danieledel288-code/RC-Ball-Launching-Buggy/media/Bottom Up View.jpeg

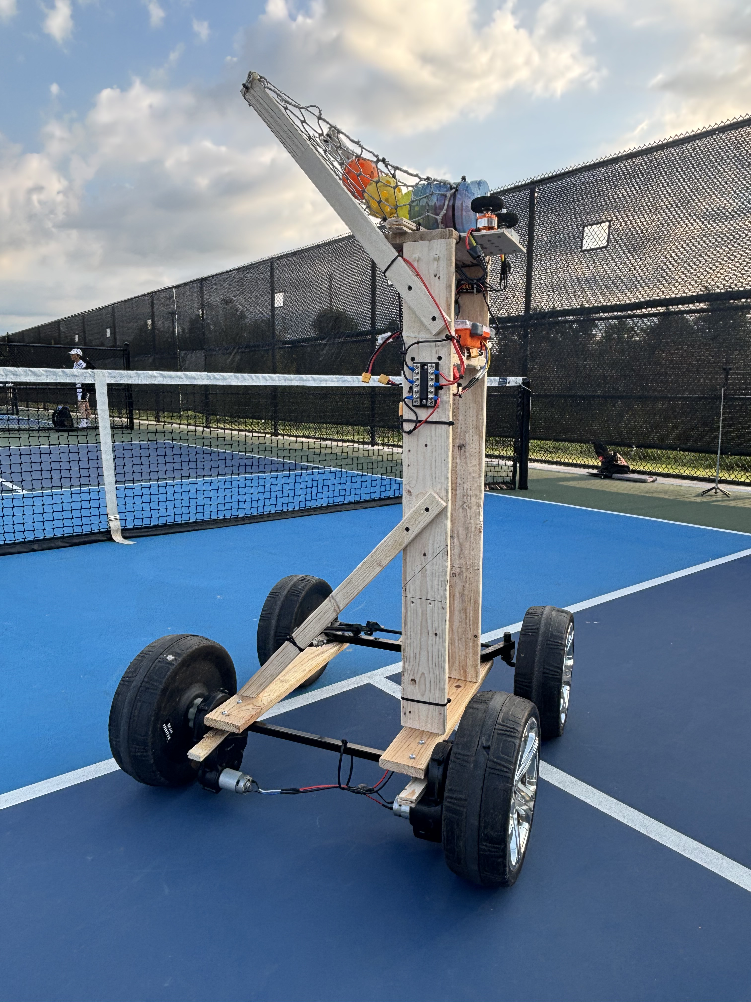
media/Bottom Up View.jpeg
