danieledel288-code/RC-Ball-Launching-Buggy/media/Fly Wheel Veiw.jpeg

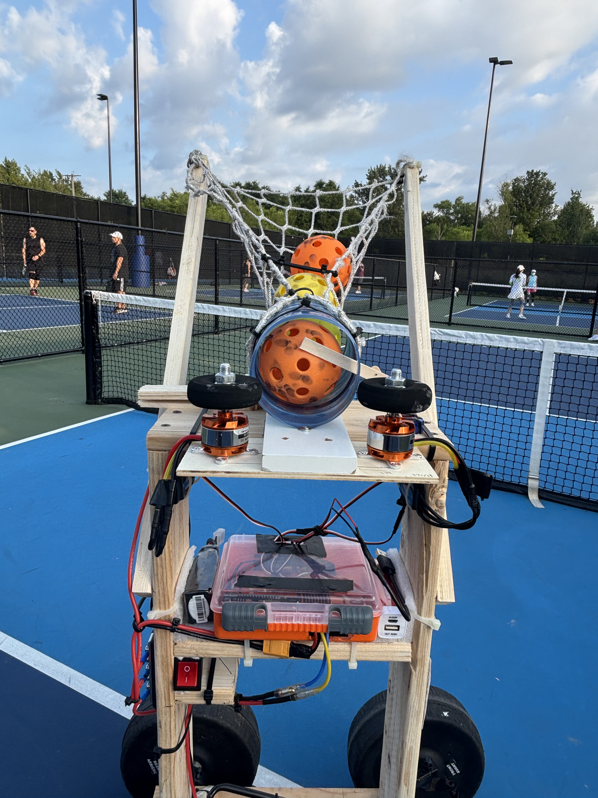
media/Fly Wheel Veiw.jpeg
