danieledel288-code/RC-Ball-Launching-Buggy/README.md

# RC Ball-Launching Buggy

Control code for an autonomous pickleball launcher built on a gutted toy car chassis, entered in the Blueprint.io Summer Build Contest.

An ESP32 hosts its own WiFi access point, so a phone can connect and control the launcher directly with no home router or internet connection needed. Two flywheel ESCs, a drive ESC, and a gate servo are all driven through a PCA9685 PWM board over I2C. The net stores a batch of balls and feeds them one at a time through the gate rather than catching live returns.

## Files

- **`flywheel_control/flywheel_control.ino`** - Manual control sketch. Hosts a WiFi access point and a web control page: arm/stop, independent speed sliders for each flywheel motor, gate open/close, and a confirm-gated "Drive Burst" button that runs the drive ESC forward for 2 seconds then returns to neutral. Includes a heartbeat watchdog that stops the flywheel/drive motors if the connection to the phone is lost.
- **`train/train.ino`** - Demo/training sketch. The buggy is always fully stopped when it shoots: SHOOT (gate open, drive neutral) -> cooldown -> DRIVE one segment -> cooldown -> SHOOT again. "Balls per pass" shots include both endpoints of the net length - 2 per pass fires one at the near end and one at the far end, 4 per pass fires at the near end, 1/3, 2/3, and the far end. The last shot of a pass is already at the far end, so direction flips and the next pass's first shot fires right there with no extra drive (the one exception is a 1-ball pass, which still drives the full length after its single shot since there's no second endpoint to space against). Flywheels spin up once and stay spinning through the whole run. Gate open time (500ms) and the post-shoot pause (300ms) are fixed in code, not user-adjustable - both tested fine and didn't need sliders.
  - **Spin:** a 3-way selector (Straight / Spin right / Spin left) next to Flywheel Power. Spin runs one flywheel 50 points slower than the other - e.g. at 75% power, "spin right" holds the right motor at 75% and drops the left to 25%. Which button actually curves the ball which way is unverified (`setFlywheels()` in code documents the assumed mapping); test both in practice and flip the mapping there if it's backwards.
  - **Forward speed / Reverse speed are separate sliders**, not one shared Drive Power. Field testing on 2026-08-16 confirmed reverse runs roughly twice as fast as forward at the same commanded percent on this ESC - same pulse value, clearly different real speed. Forward: min 40%, default 60%. Reverse: min 30%, default 30%. The two defaults are picked to feel roughly speed-matched in practice; tune independently from here.
  - **Direction-change double-tap** (fixed, not exposed as sliders): the first drive segment after an in-run direction flip goes neutral hold -> brief arm-tap pulse in the new direction -> neutral again -> the real pulse that actually drives. This was pulled out on 2026-08-16 once separate forward/reverse speed sliders existed, on the theory that slowing reverse down would fix the "doesn't reverse" symptom too - it didn't. Field test confirmed the Traverse Test's own Reverse toggle drove fine on its own (it never transitions from forward within a session), but real Train mode's in-run flip silently failed to move again without the double-tap, so it's back - same values as before (500ms settle, 300ms arm-tap), just not shown as sliders since they're not something that needs day-to-day tuning. `drivePulseFor()` is the one place that picks forward vs. reverse speed for any drive pulse, used by both this sequence and ordinary same-direction segments.
  - Main screen: balls to fire, balls per pass, flywheel power + spin, forward speed, reverse speed, traverse time (default 6.0s - how long a full end-to-end drive takes, still not measured against the real net, needs a bench test).
  - Advanced Settings holds the post-drive pause, a **pass change pause** (default 1000ms - covers the pass-boundary gap where the last shot of one pass and the first shot of the next land on the same physical spot with no drive between them), and a **Traverse Test** tool with its own Forward/Reverse toggle for isolating drive-only calibration in either direction, no ball or gate involved.
  - Serial Monitor logs each shot fired, each direction flip, and each drive segment's direction/pulse/target duration - useful for confirming the sequence is doing what you expect when it's hard to tell by eye. Same heartbeat safety stop as the manual sketch. Only one sketch runs on the ESP32 at a time - flash whichever one you need for that session.
- **`esc_calibration/esc_calibration.ino`** - Standalone sketch for calibrating the flywheel ESCs' throttle range through the PCA9685, step-paced over Serial Monitor rather than on a timer.

## Gate calibration

`GATE_OPEN_ANGLE` / `GATE_CLOSED_ANGLE` are set from a 2026-08-11 bench test on the ball-storage gate (20 degrees = open, 160 = closed). If the gate hardware changes, re-test and update both constants in `flywheel_control.ino` and `train.ino` together - they're independent copies, not shared.

## Channel map (PCA9685)

- 0 - gate servo
- 1 - left flywheel ESC
- 2 - right flywheel ESC
- 3 - drive ESC (QuicRun 1060, both drive motors wired in parallel)

## Hardware

- Freenove ESP32-WROOM DevKit
- PCA9685 16-channel PWM driver (I2C)
- 2x brushless flywheel motors + ESCs (mounted on salvaged RC plane landing gear wheels)
- Hobbywing QuicRun 1060 ESC driving both stock toy-car drive motors in parallel
- 1x gate servo (ball feed)
- 3S LiPo battery + physical inline kill switch, powers the bus bar and all 3 ESCs
- 5V 1A USB power bank, powers the PCA9685 (V+) and ESP32 - a separate battery from the motor rail, not a UBEC

## Libraries required

- `Adafruit PWM Servo Driver Library` (Arduino Library Manager)
- Built-in `WiFi.h` / `WebServer.h` (ESP32 board package)

## Setup

1. Wire the PCA9685: ESP32 GPIO21 -> SDA, GPIO22 -> SCL, ESP32 3.3V -> VCC, shared GND. Servo power (V+) comes from a separate 5V 1A USB power bank, not the motor battery and not a UBEC - keeping logic power off the motor rail is what stops ESC current draw from ever browning out the ESP32.
2. Flash `flywheel_control.ino`. On boot it prints its access point name and IP address to Serial Monitor (115200 baud).
3. Connect a phone to the ESP32's WiFi network and open the printed IP address in a browser.
4. Arm, then use the sliders to test each flywheel independently before combining them.
5. Note the drive ESC is bidirectional and arms at neutral (1500us), unlike the flywheel ESCs which arm at minimum (1000us) - this is handled automatically in code, just worth knowing if you're debugging with a scope/logic analyzer.

## Media

View photos, timelapses, and test videos in [`media/`](media/).
