danieledel288-code/RC-Ball-Launching-Buggy/media/Launcher View.jpeg

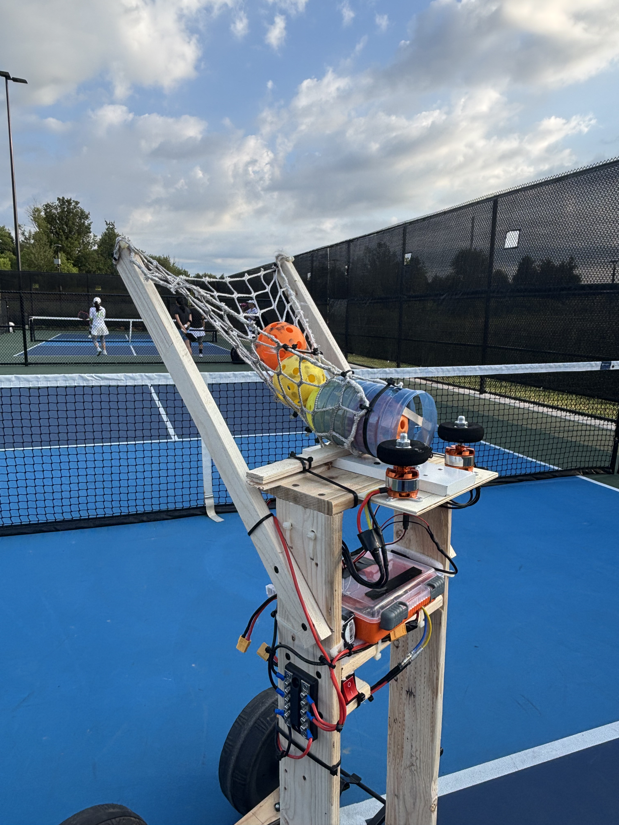
media/Launcher View.jpeg
