danieledel288-code/RC-Ball-Launching-Buggy/media/Render.png

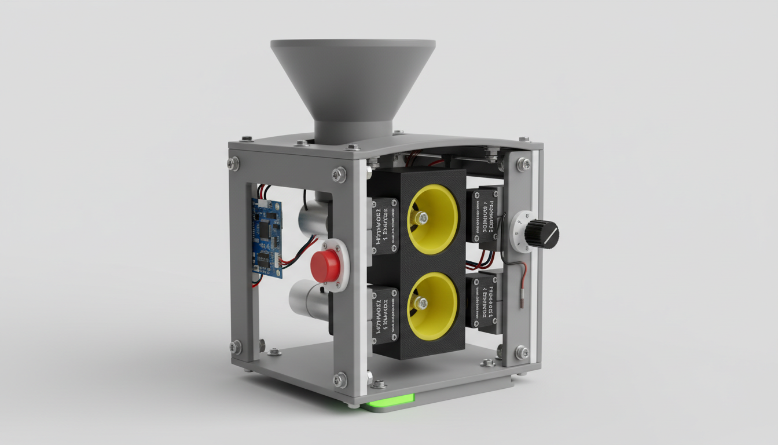
media/Render.png
