danieledel288-code/RC-Ball-Launching-Buggy/media/Side Veiw.jpeg

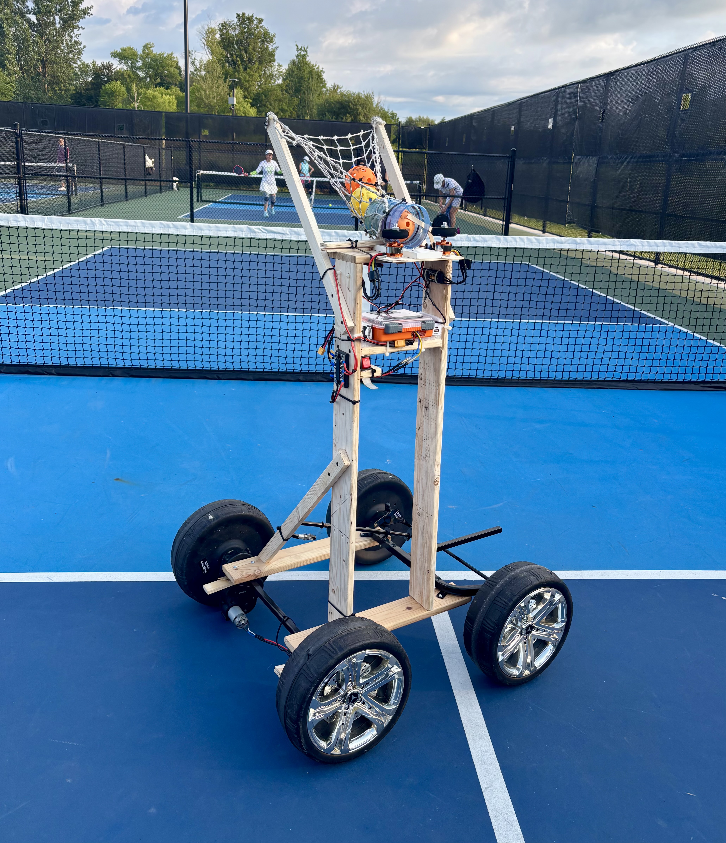
media/Side Veiw.jpeg
