danieledel288-code/RC-Ball-Launching-Buggy/media/wifi_qr.png

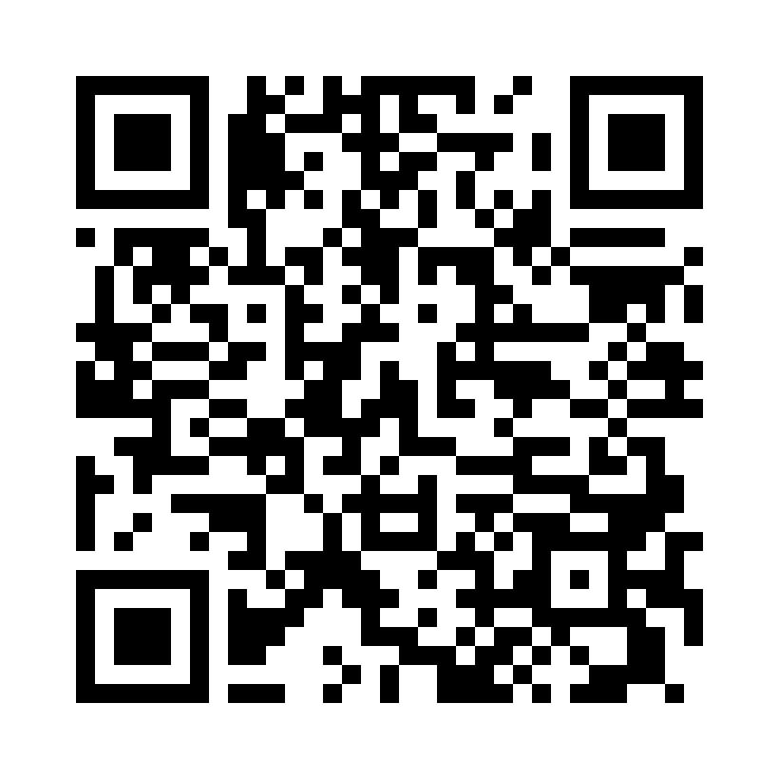
media/wifi_qr.png
