danieledel288-code/RC-Ball-Launching-Buggy/(commit log)

2026-08-03 Add ESP32 flywheel/servo control code for pickleball launcher
2026-08-05 Add QuicRun 1060 drive ESC channel and 2s drive burst
2026-08-05 Fix channel assignment: 0=servo, 1=left, 2=right
    [flywheel_control.ino]
2026-08-05 Update README with drive ESC channel map and hardware
2026-08-10 Add continuous drive speed slider with reverse, fix heartbeat drive reset
    Adds a bidirectional (-100..100) drive slider to the web UI alongside
    the existing flywheel sliders, reusing the same +/-150us envelope
    already proven safe by Drive Burst. Also fixes a gap where heartbeat
    timeout reset the flywheel channels but not CH_DRIVE, which mattered
    once drive became a live continuous control instead of a one-shot
    blocking burst.
    [flywheel_control.ino]
2026-08-11 Raise drive throttle ceiling after successful first test
    1650->1800us burst, slider envelope 150->300us. Doubling the
    previous conservative starting point now that wiring, direction,
    and calibration are confirmed working safely.
2026-08-11 Add train mode, fix gate calibration, document real power/BOM
    Gate open/close angles were swapped in flywheel_control.ino after a
    bench test on the new ball-storage gate showed them backwards.
    New train/train.ino: unattended demo sequencer with a tunable ball
    count, flywheel power, drive power, drive burst length, direction-
    change pause, and gate open time. Fires one ball per cycle,
    alternating drive direction, non-blocking state machine so STOP
    stays responsive with motors spinning. Full green/gold/white UI
    redesign for the isolated-AP control page.
    BOM.md documents the real Jul 16 AliExpress order plus owned/
    salvaged parts. README updated to match the actual two-battery
    power split (mo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
    [flywheel_control.ino, train.ino]
2026-08-11 Add WiFi-join QR code for the ESP32 access point
    iPhone can't auto-join WPA2 networks from an NFC tag (no public
    Shortcuts/CoreNFC API for it), so a QR code is the actual native
    one-tap join path via the Camera app. Verified by decoding the
    generated image back to the exact WIFI: string, not just trusting
    the encode.
2026-08-14 Rewrite train.ino: stop-and-shoot mechanism, balls-per-pass
    Replaced fire-while-driving with discrete SHOOT -> cooldown -> DRIVE
    segment -> cooldown, matching how the buggy actually needs to behave
    (fully stopped for every shot). New "balls per pass" splits one net
    length into equal segments and fires at each one; direction only
    flips after a full pass completes, not every shot. Drive burst
    length is now "traverse time" (full net length, divided by balls
    per pass automatically) - explicitly flagged as unmeasured, needs a
    real bench test. Gate open time and the two cooldown pauses moved
    into a collapsible Advanced Settings section. New default: 4 balls,
    4 per pass (single one-way pass by defa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
    [train.ino]
2026-08-14 Add ball-free traverse test to Advanced Settings
    New T_TEST_DRIVE state and /testdrive endpoint drive the buggy
    forward at the current Drive Power / Traverse Time values with the
    gate and flywheels untouched, so the full-length timing can be
    dialed in by trial and error without loading or firing any balls.
    Reuses the same sliders the real run uses, rather than a separate
    duplicate set of test-only values, so whatever gets calibrated here
    is exactly what the actual sequence divides into segments.
    [train.ino]
2026-08-14 Fix traverse-test accuracy, ball/leg debug logging, UI cleanup
    Traverse Test now runs the same number of stop-start segments as
    "balls per pass" instead of one continuous burst - a continuous test
    was calibrating a Traverse Time that then fell short in the real
    segmented run, because restarting from a dead stop several times
    costs more distance-per-second than accelerating once. This was the
    root cause of the reported "falls short of full length" bug.
    Added Serial logging for every shot fired and every direction flip,
    so the balls-per-pass/reversal sequence can be verified against the
    log instead of just watching the buggy.
    Gate open time hardcoded to 500ms and dropped from the UI entirely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
    [train.ino]
2026-08-15 Fix balls-per-pass positioning, hardcode post-shoot pause, add spin test
    Balls-per-pass shots now include both endpoints of the net length
    (2 per pass = one at each end) instead of stopping short of the far
    end and needing a trailing drive segment. This was the root cause of
    the reported bug: 4 balls/2 per pass was firing at start, middle,
    end, end instead of start, end, end, start. The last shot of a pass
    now already sits at the far end, so the direction flip and next
    pass's first shot happen with no extra drive - the one exception is
    a 1-ball pass, which still needs one full-length trailing segment
    since there's no second endpoint to space against.
    Post-shoot pause hardcoded to 300ms and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
    [train.ino]
2026-08-15 Replace flywheel-only spin test with real ball-spin control
    "Spin" now means what it should: a 3-way Straight/Spin right/Spin
    left selector next to Flywheel Power that runs one flywheel 50
    points slower than the other to curve the ball, applied to every
    real shot (not just an isolated test). Added setFlywheels() to
    compute and apply the differential in one place instead of
    duplicating the equal-speed logic in every handler.
    Renamed the previous flywheel-only test tool from "Spin Test" to
    "Flywheel Test" to avoid the naming collision - it now also respects
    the spin setting, so it doubles as the way to empirically figure out
    which button actually curves the ball which direction (documented in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
    [train.ino]
2026-08-15 Fix missing reverse via direction-settle hold, UI cleanup
    Real bug found in the field: the pass-2 return leg wasn't driving at
    all after the direction flip. Working theory (Daniel's, matches
    common bidirectional-ESC behavior): the QuicRun 1060 reads a reverse
    command arriving right after forward as a brake, not an actual
    reverse, unless the signal explicitly holds at neutral first. Added
    a T_DIR_SETTLE state - an explicit neutral pulse held for 500ms
    (tunable in Advanced Settings), inserted only on the first drive
    segment after a pass reverses, before the reverse pulse is sent.
    Same-direction segments within a pass are unaffected.
    Also: back-to-back same-position shots at a pass boundary (e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
    [train.ino]
2026-08-15 Add a dedicated pass-change pause, separate from post-shoot pause
    The last shot of one pass and the first shot of the next land at
    the same physical spot with no drive between them, so the flat
    300ms post-shoot pause was the only gap between them - too tight.
    New T_PASS_PAUSE state adds a separate 1000ms pause (tunable in
    Advanced Settings) specifically at that boundary, on top of the
    existing 300ms, without touching the pause between any other pair
    of shots.
    [train.ino]
2026-08-15 Add double-tap reverse arm sequence, UI cleanup
    A plain neutral-then-reverse still wasn't reversing in the field.
    Revised theory: this class of bidirectional ESC often reads the
    FIRST reverse command after forward motion as a brake/arm signal,
    not real reverse - a second reverse command, with a neutral gap in
    between, is what's actually needed to drive backward. New sequence
    on a direction flip: neutral hold -> brief reverse "tap" (T_DIR_ARM,
    eaten as brake) -> neutral again -> real reverse pulse (starts
    T_DRIVE). Both hold times are tunable in Advanced Settings.
    UI: spin pills now vertically centered (flex+nowrap, was relying on
    default button text alignment which broke if a label wrapped)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
    [train.ino]
2026-08-15 Add active braking at end of every drive segment
    Field test: buggy overshot its 6-second Traverse Time and smashed
    into the wall it started from after a reverse run. Root cause -
    cutting to neutral only stops sending drive power, it doesn't
    actively stop the buggy; momentum (compounded by the ESC's own
    soft-start still ramping up speed through most of the segment)
    carried it well past where the motor turned off.
    New T_BRAKE state (and T_TEST_BRAKE for the calibration tool) fires
    a brief opposite-direction pulse at the end of every drive segment
    before going to neutral - reuses the same mechanism already proven
    by the reverse arm-tap fix (this ESC reads an opposite-direction
    pulse as a brake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
    [train.ino]
2026-08-15 Add per-segment Serial logging for drive start/end and braking
    No confirmed code bug found by re-tracing the state machine for the
    reported "reverses full speed, no stop" - the T_DRIVE exit condition
    and brake logic are identical for forward and reverse segments on
    inspection. Logging the actual pulse value, target duration, and
    real elapsed time at drive-start/drive-end/brake-end so the next
    field test gives hard numbers instead of another guess.
    [train.ino]
2026-08-15 Add Forward/Reverse toggle to Traverse Test for direct A/B testing
    Field log confirmed the reverse segment's pulse value and target
    duration matched what the code intended - the timing/pulse math
    isn't the bug. The buggy still went "full send" in reverse (50%
    drive power, 3s) and had to be stopped manually before its own
    segment timer would have fired. Two live theories, not yet
    distinguished: this ESC's reverse throttle range may not be
    symmetric with forward (same offset from neutral reads faster in
    reverse), or the reverse leg was just driving back toward the wall
    it started next to while forward had open space, making identical
    real speed look far more dangerous.
    Rather than guess-fixin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
    [train.ino]
2026-08-15 Split drive power into forward/reverse sliders, drop settle/arm/brake
    Field test confirmed reverse runs roughly 2x as fast as forward at
    the same commanded percent on this ESC - same pulse value, clearly
    different real speed. That's the actual root cause of the "full
    send" reverse behavior, not a timing or braking problem. Replaced
    the single Drive Power slider with Forward Speed (min 40%, default
    60%) and Reverse Speed (min 30%, default 30%), so the two directions
    can be tuned to feel speed-matched independently.
    Removed the direction settle/arm-tap double-tap sequence and the
    end-of-segment brake pulse - now that reverse has its own slower
    default, the extra machinery introduced to fight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
    [train.ino]
2026-08-15 Restore direction-change double-tap as fixed (non-slider) behavior
    Field test: with the settle/arm-tap sequence removed, a real in-run
    direction flip silently failed to move the buggy again, even with
    reverse's own slower default speed. Traverse Test's Reverse toggle
    worked fine in isolation because it never transitions from forward
    within the same session - only a real flip mid-run hits the ESC's
    brake-vs-reverse ambiguity. Re-added the same sequence (neutral hold
    -> arm-tap -> neutral -> real pulse) but as fixed constants
    (DIR_SETTLE_MS, DIR_ARM_MS), not user-facing sliders - the request
    was to stop showing this in the UI, not to remove the behavior.
    Also fixed spin-opt button text not be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
    [train.ino]
2026-08-15 Cosmetic pass: credit line, spacing, drop balls-per-pass hint
    Added a byline under the title ("Made by Daniel Edelstein with
    Blueprint.io"), removed the hint text under Balls to fire/Balls per
    pass, and balanced the spacing around the Straight/Spin right/Spin
    left pills so they sit centered between the Flywheel Power and
    Forward Speed sliders instead of hugging the one above.
2026-08-15 Rename IMG_1311.jpeg to Fly Wheel Veiw.jpeg
