danieledel288-code/RC-Ball-Launching-Buggy/media/Electrical.jpeg

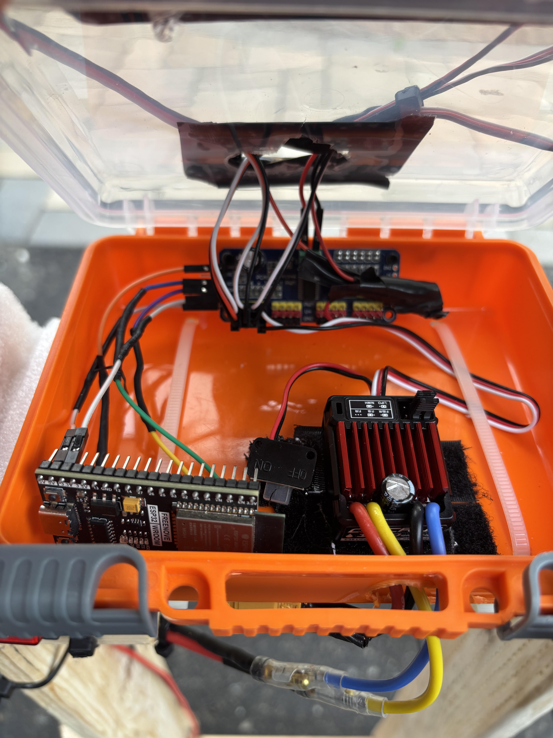
media/Electrical.jpeg
